openxc-retro-gauge/retro-gauge/enclosure/makerbot_friendly/gaugeTop_Makerbot.stl

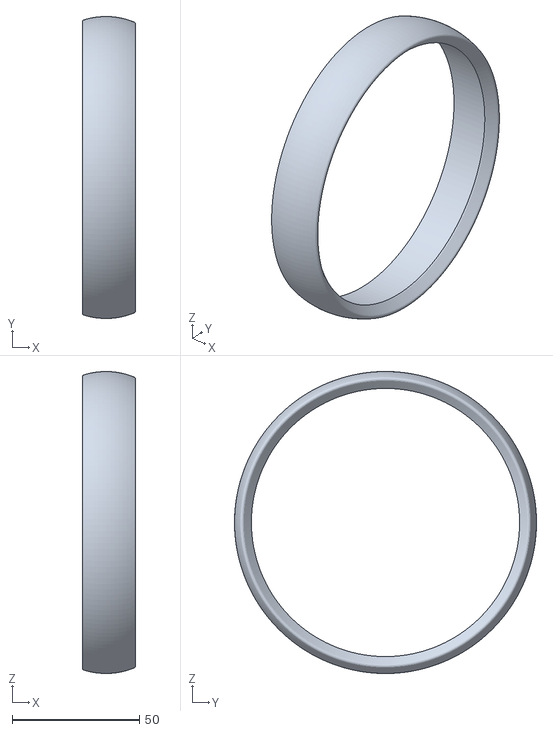
[picture p1: CAD file, 2013-04-17, last stored version]
enclosure/makerbot_friendly/gaugeTop_Makerbot.stl
21.0 x 118.5 x 118.5
