openxc-retro-gauge/retro-gauge/enclosure/needle_v2.stl

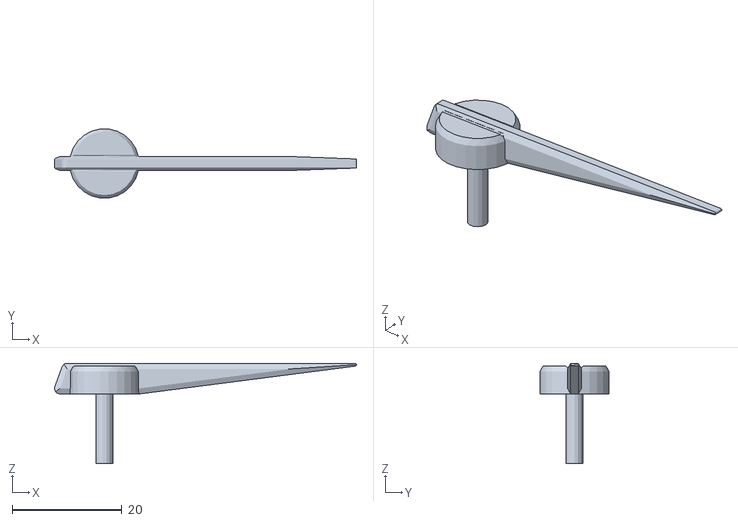
[picture p2: CAD file, 2013-07-15, last stored version]
enclosure/needle_v2.stl
55.1 x 12.6 x 18.3
