openxc-retro-gauge/retro-gauge/enclosure/gaugeFace.dxf

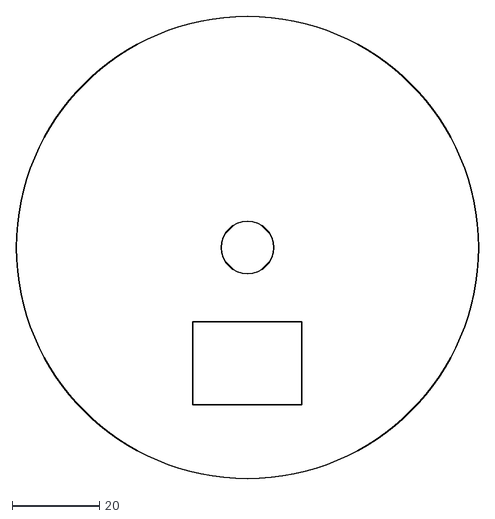
[picture p3: CAD file, 2013-04-18, last stored version]
enclosure/gaugeFace.dxf
106.0 x 106.0
