openxc-retro-gauge/retro-gauge/enclosure/makerbot_friendly/Needle_Makerbot.stl

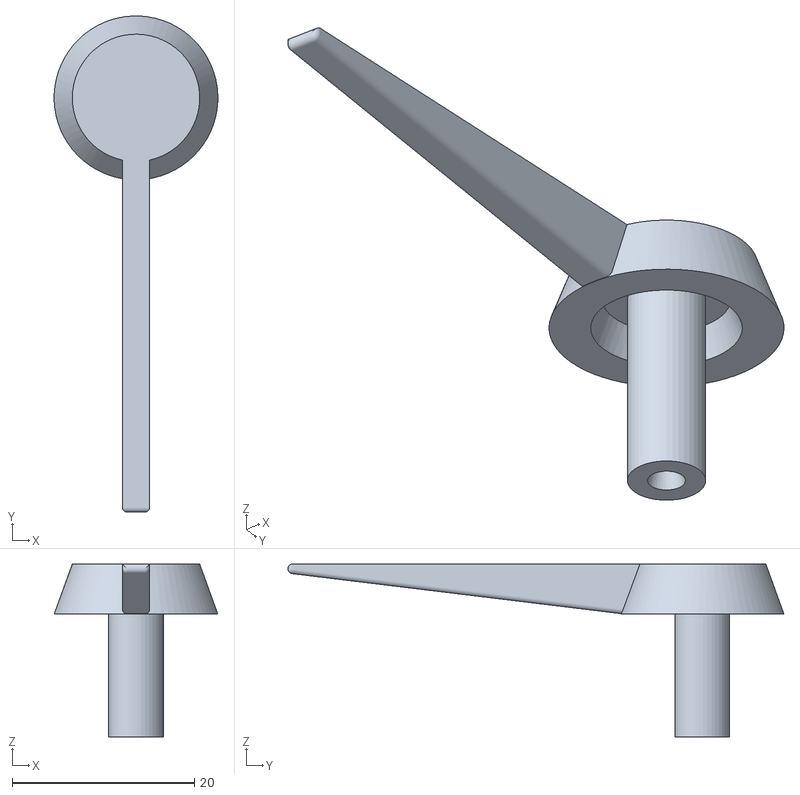
[picture p4: CAD file, 2013-04-17, last stored version]
enclosure/makerbot_friendly/Needle_Makerbot.stl
18.0 x 54.5 x 19.0
