openxc-retro-gauge/retro-gauge/enclosure/gaugeBase.stl

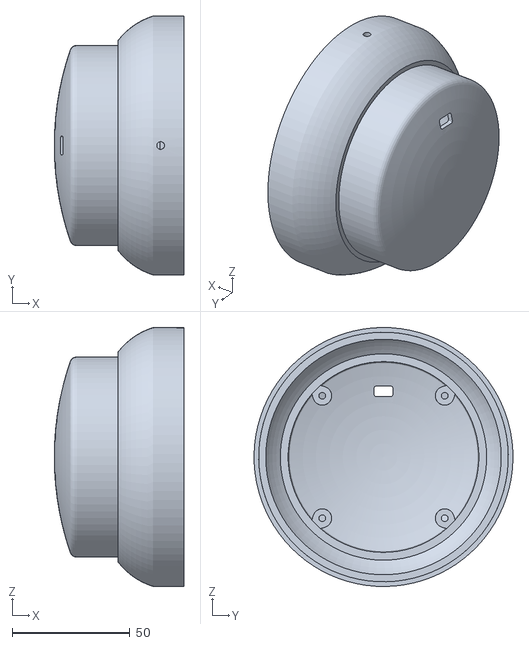
[picture p5: CAD file, 2013-01-09, last stored version]
enclosure/gaugeBase.stl
55.0 x 110.0 x 110.0
