openxc-retro-gauge/retro-gauge/enclosure/gaugeTop.stl

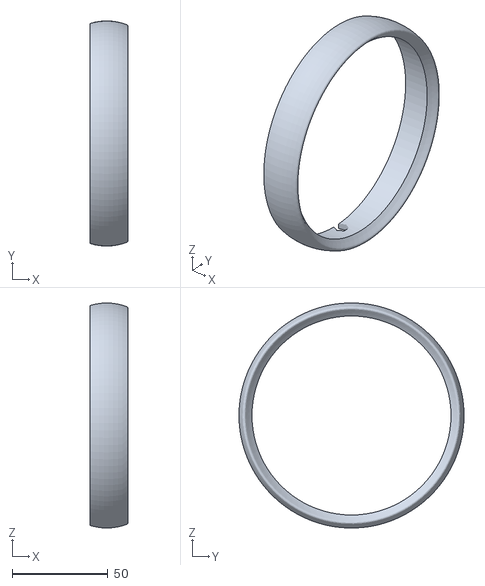
[picture p6: CAD file, 2013-01-09, last stored version]
enclosure/gaugeTop.stl
19.8 x 117.7 x 117.6
