openxc-retro-gauge/retro-gauge/schematics/GaugeRev2.brd

## EAGLE design schematics/GaugeRev2.brd (2013-01-09, last stored version)

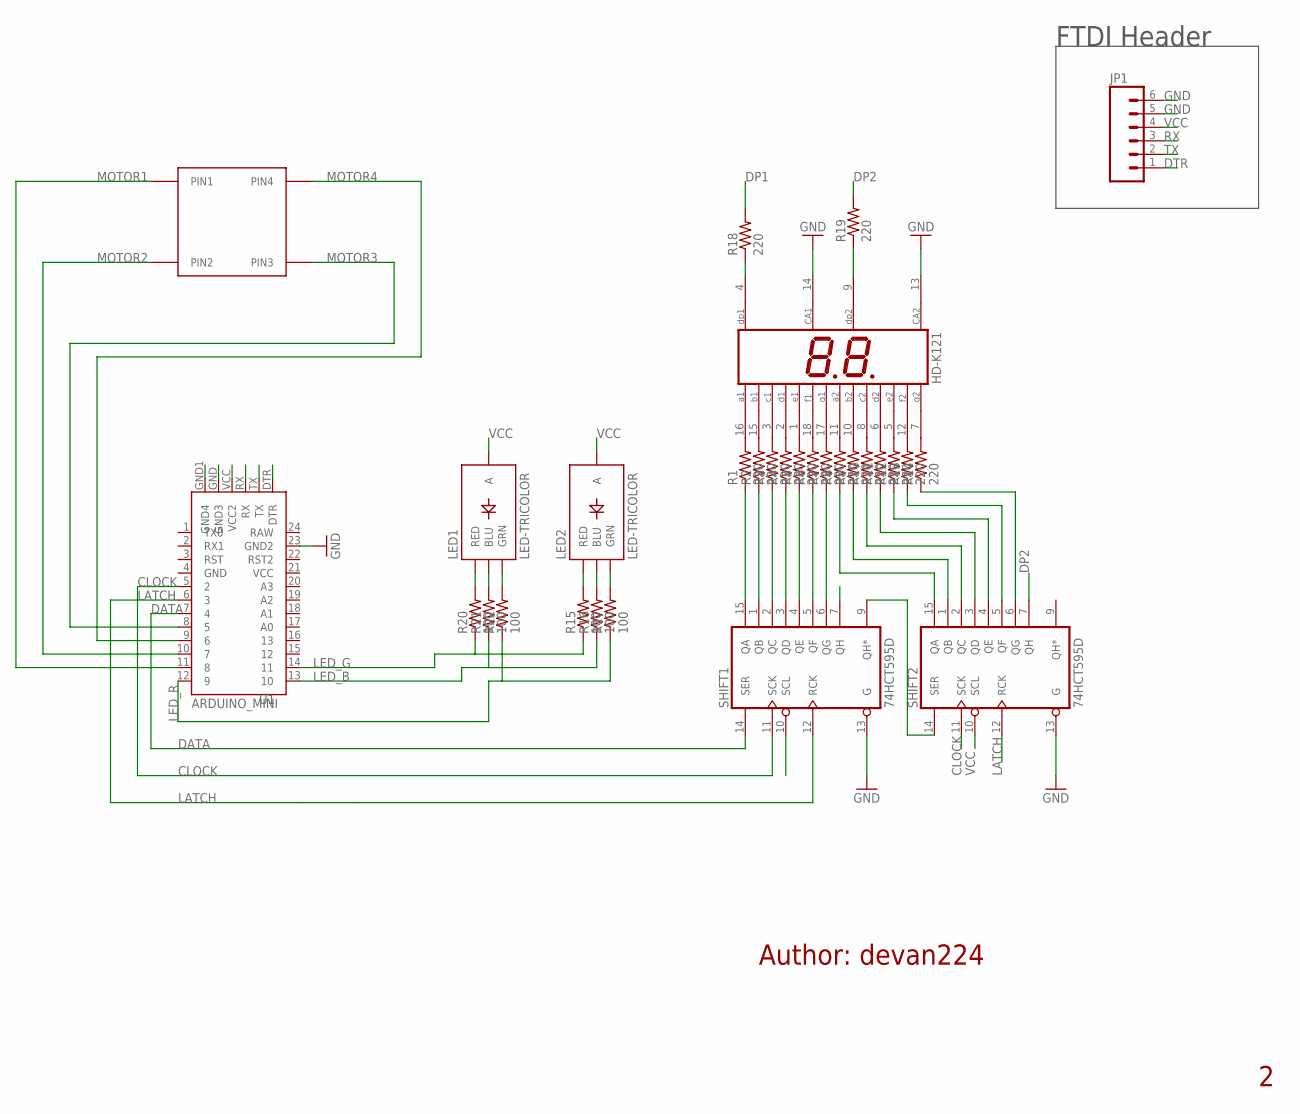
[picture p7: schematic GaugeRev2.sch]

Parts:
DIS2: HD-K121; HDSP-R
JP1: M06SIP; 1X06
LED1, LED2: LED-TRICOLOR; LED-TRICOLOR-SMD
R1, R2, R3, R4, R5, R6, R7, R8, R9, R10, R11, R12, R13, R14, R18, R19: 220; R1206
R15, R16, R17, R20, R21, R22: 100; R1206
SHIFT1, SHIFT2: 74HCT595D; SO16
U1: ARDUINO_MINI
U2: VID29

Connections:
1: DIS2.4 (DP1), R18.1
2: DIS2.9 (DP2), R19.1
A1: R1.1, SHIFT1.15 (QA)
A2: R8.1, SHIFT2.15 (QA)
B1: R2.1, SHIFT1.1 (QB)
B2: R9.1, SHIFT2.1 (QB)
C1: R3.1, SHIFT1.2 (QC)
CLOCK: SHIFT1.11 (SCK), SHIFT2.11 (SCK), U1.5 (2)
D1: R4.1, SHIFT1.3 (QD)
DATA: SHIFT1.14 (SER), U1.7 (4)
DP1: R18.2, SHIFT1.7 (QH)
DP2: R19.2, SHIFT2.7 (QH)
DTR: JP1.1, U1.DTR
E1: R5.1, SHIFT1.4 (QE)
F1: R6.1, SHIFT1.5 (QF)
G1: R7.1, SHIFT1.6 (QG)
G2: R14.1, SHIFT2.6 (QG)
GND: DIS2.13 (CA2), DIS2.14 (CA1), JP1.5, JP1.6, SHIFT1.8 (GND), SHIFT1.13 (G), SHIFT2.8 (GND), SHIFT2.13 (G), U1.23 (GND2), U1.GND (GND3), U1.GND1 (GND4)
LATCH: SHIFT1.12 (RCK), SHIFT2.12 (RCK), U1.6 (3)
LED_B: R16.1, R21.1, U1.13 (10)
LED_G: R15.1, R20.1, U1.14 (11)
LED_R: R17.1, R22.1, U1.12 (9)
MOTOR1: U1.11 (8), U2.PIN1
MOTOR2: U1.10 (7), U2.PIN2
MOTOR3: U1.8 (5), U2.PIN3
MOTOR4: U1.9 (6), U2.PIN4
unnamed: DIS2.16 (A1), R1.2
unnamed: DIS2.15 (B1), R2.2
unnamed: DIS2.3 (C1), R3.2
unnamed: DIS2.2 (D1), R4.2
unnamed: DIS2.1 (E1), R5.2
unnamed: DIS2.18 (F1), R6.2
unnamed: DIS2.17 (G1), R7.2
unnamed: DIS2.11 (A2), R8.2
unnamed: DIS2.10 (B2), R9.2
unnamed: DIS2.8 (C2), R10.2
unnamed: DIS2.6 (D2), R11.2
unnamed: DIS2.5 (E2), R12.2
unnamed: DIS2.12 (F2), R13.2
unnamed: DIS2.7 (G2), R14.2
unnamed: LED2.G (GRN), R17.2
unnamed: LED2.B (BLU), R16.2
unnamed: R10.1, SHIFT2.2 (QC)
unnamed: R11.1, SHIFT2.3 (QD)
unnamed: R12.1, SHIFT2.4 (QE)
unnamed: R13.1, SHIFT2.5 (QF)
unnamed: LED2.R (RED), R15.2
unnamed: LED1.G (GRN), R22.2
unnamed: LED1.B (BLU), R21.2
unnamed: LED1.R (RED), R20.2
Q*: SHIFT1.9 (QH*), SHIFT2.14 (SER)
RX: JP1.3, U1.RX
TX: JP1.2, U1.TX
VCC: JP1.4, LED1.A, LED2.A, SHIFT1.10 (SCL), SHIFT1.16 (VCC), SHIFT2.10 (SCL), SHIFT2.16 (VCC), U1.VCC (VCC2)

Notes on the sheet:
Author: devan224
FTDI Header

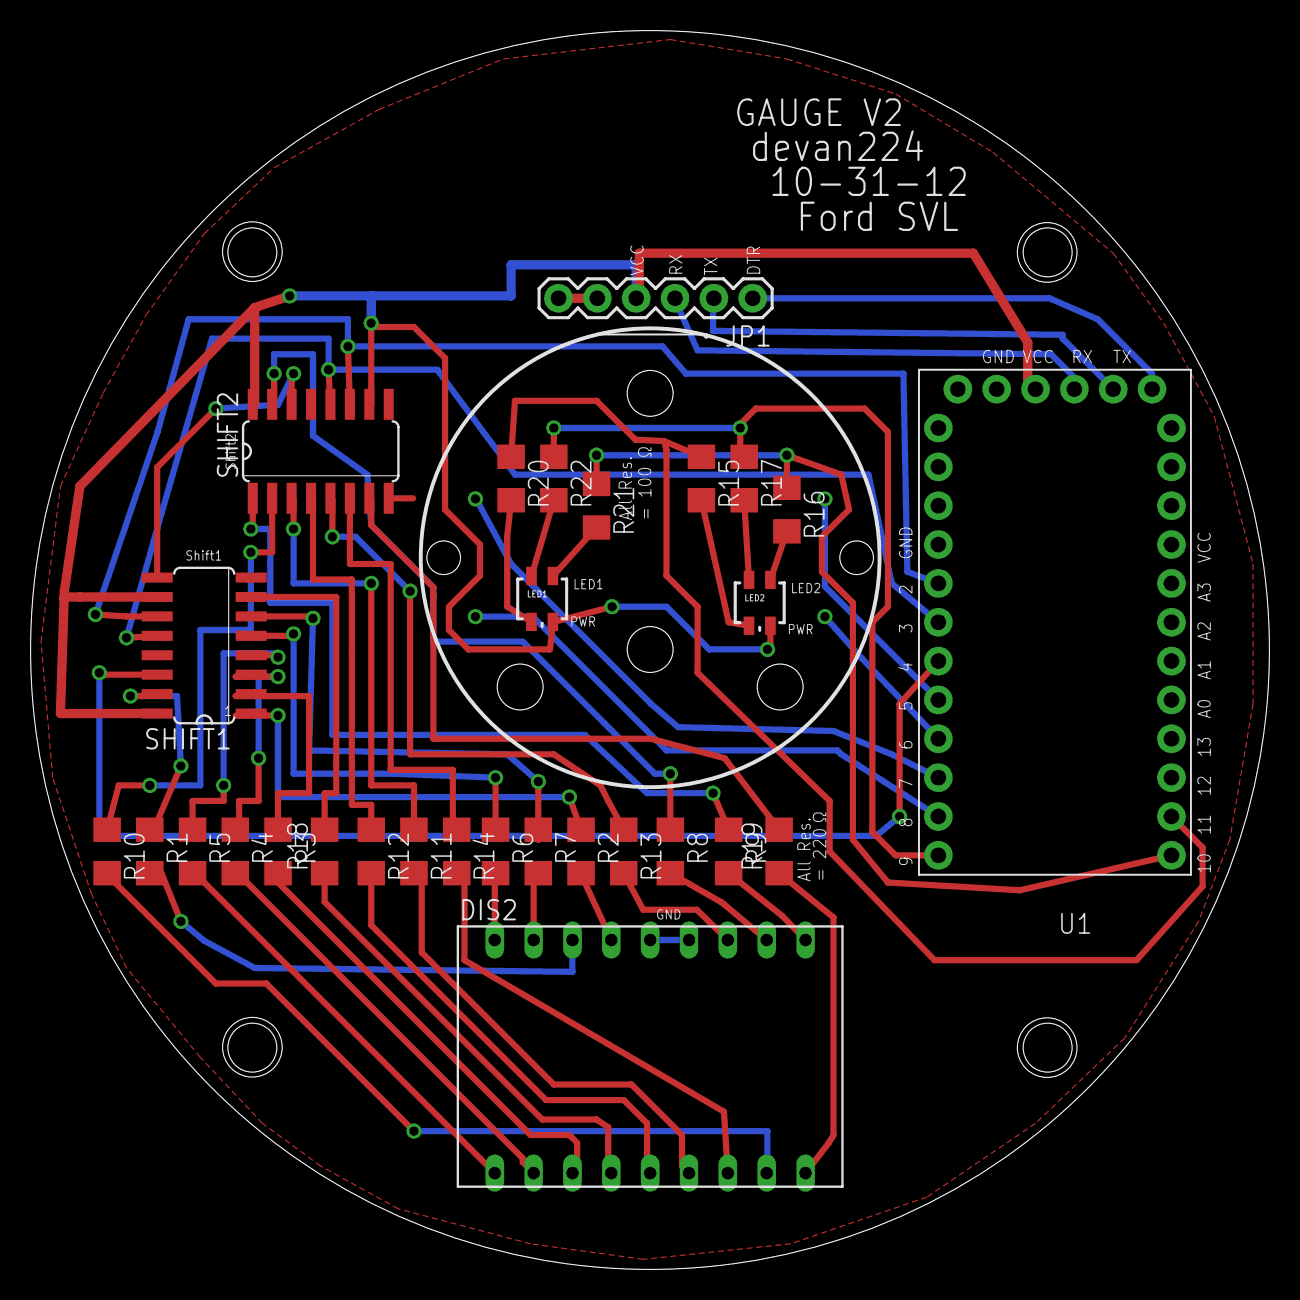
[picture p8: board GaugeRev2.brd from above]

Board: 2 copper layers, 81.0 x 81.0 mm, 30 parts (0 on the bottom side), 54 nets.
