openxc-retro-gauge/retro-gauge/(commit log)

2013-01-09 Add enclosure step files and schematics.
    [GaugeRev2.brd, GaugeRev2.sch, gaugeBase.stl, gaugeTop.stl]
2013-01-09 Add Android app and Arduino firmware for guage.
2013-01-09 Add BOM.
    [BOM.csv]
2013-01-09 Add Arduino README.
2013-01-10 Add docs on inner workings of Gauge Driver.
2013-01-23 Bug fix: toggle switch is no longer reversed.
2013-04-17 adding MakerBot Friendly housings
    [Needle_Makerbot.stl, gaugeTop_Makerbot.stl]
2013-04-17 Updated BOM
    [Gauge-BOM.xls]
2013-04-17 updated makerbot models
    [gaugeTop_Makerbot.stl]
2013-04-18 adding .dxf file for creating Gauge Face
    [gaugeFace.dxf]
2013-04-24 adding instructables link on the README file and an updated BOM
    [Gauge-BOM.xls]
2013-04-25 adding makerbot file for printing
2013-04-27 Connect device when attached.
2013-04-30 updating BOM
    [Gauge-BOM.xls]
2013-05-17 Made the speed, mpg, steering wheel angle, fuel, and odo thread safe.
2013-05-30 Fixed re-connection bug with multiple devices. Now handles device disconnects properly with multiple devices.
2013-07-12 Document the difference in the makerbot-friendly STL files.
2013-07-12 Move needle STL up a level since it's not MakerBot-specific.
    [needle.stl]
2013-07-15 this commit is to add a new version of the needle to the repository
    [needle_v2.stl]
2013-07-18 Bump Arduino-Makefile.
2013-07-18 Fix board tag in Makefile.
2013-07-18 Update docs for flashing from Arduino.
2013-07-18 Use 5v Arduino Pro library to get the correct clock rate.
2013-07-18 Start function names with lower case.
2013-07-18 Rename more class methods to start with lower case.
2013-07-18 Use an existing method in upstream FTDriver to detach device.
2013-07-22 Include SwitecX25 library in .ino to trigger Arduino library compilation.
2013-07-23 Grab SWA and speed synchronously to keep thing simple, since we're on a timer.
2013-09-11 Leave a note that repo was split up.
    [BOM.csv, Gauge-BOM.xls, GaugeRev2.brd, GaugeRev2.sch, gaugeBase.stl, gaugeFace.dxf, gaugeTop.stl, gaugeTop_Makerbot.stl]
